felipeorrico/JuniorDesignSpydercam/(commit log)

2021-03-05 Uploaded Arduino Code
2021-03-05 Added Arduino Firmware Documentation
